MadsLudvig/industrial-core-xy/README.md

# industrial-core-xy
Large scale 3D printer made with old servomotor parts from CNC cantilever robots
