MadsLudvig/industrial-core-xy/DuetXLenze Adapter Board/DuetXLenze-kicad/README.md

# DuetXLenze

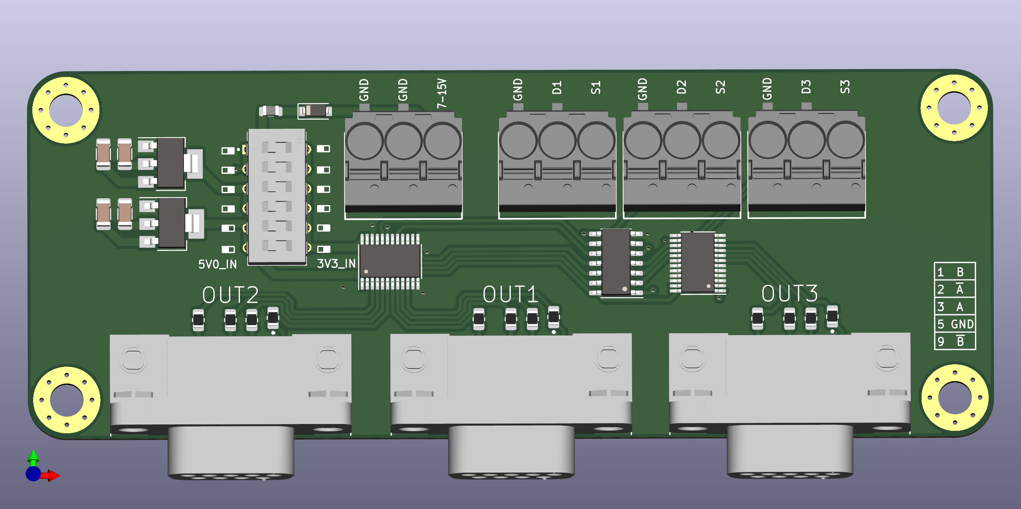
[picture p3: DuetXLenze Adapter Board/DuetXLenze-kicad/Images/DuetXLenze.png]
Preview


### Parts used

__C1 - C4__		JLCPCB Part # C13585

__D1 - D2__		JLCPCB Part # C8598

__FB1 - FB2__	JLCPCB Part # C1015

__J1 - J3__			Farnell Part # 1338747

__R1 - R12__		JLCPCB Part # C28636

__U1__				JLCPCB Part # C6187

__U2__				JLCPCB Part # C6186

__U3 + U5__		JLCPCB Part # C7859

__U4__				JLCPCB Part # C5590

__X1 - X4__		Farnell Part # 2352396

__S1__				Farnel Part # 1123939
