MadsLudvig/industrial-core-xy/DuetXLenze Adapter Board/DuetXLenze-kicad/DuetXLenze.kicad_pcb

## KiCad design DuetXLenze Adapter Board/DuetXLenze-kicad/DuetXLenze.kicad_pcb (2022-08-12)

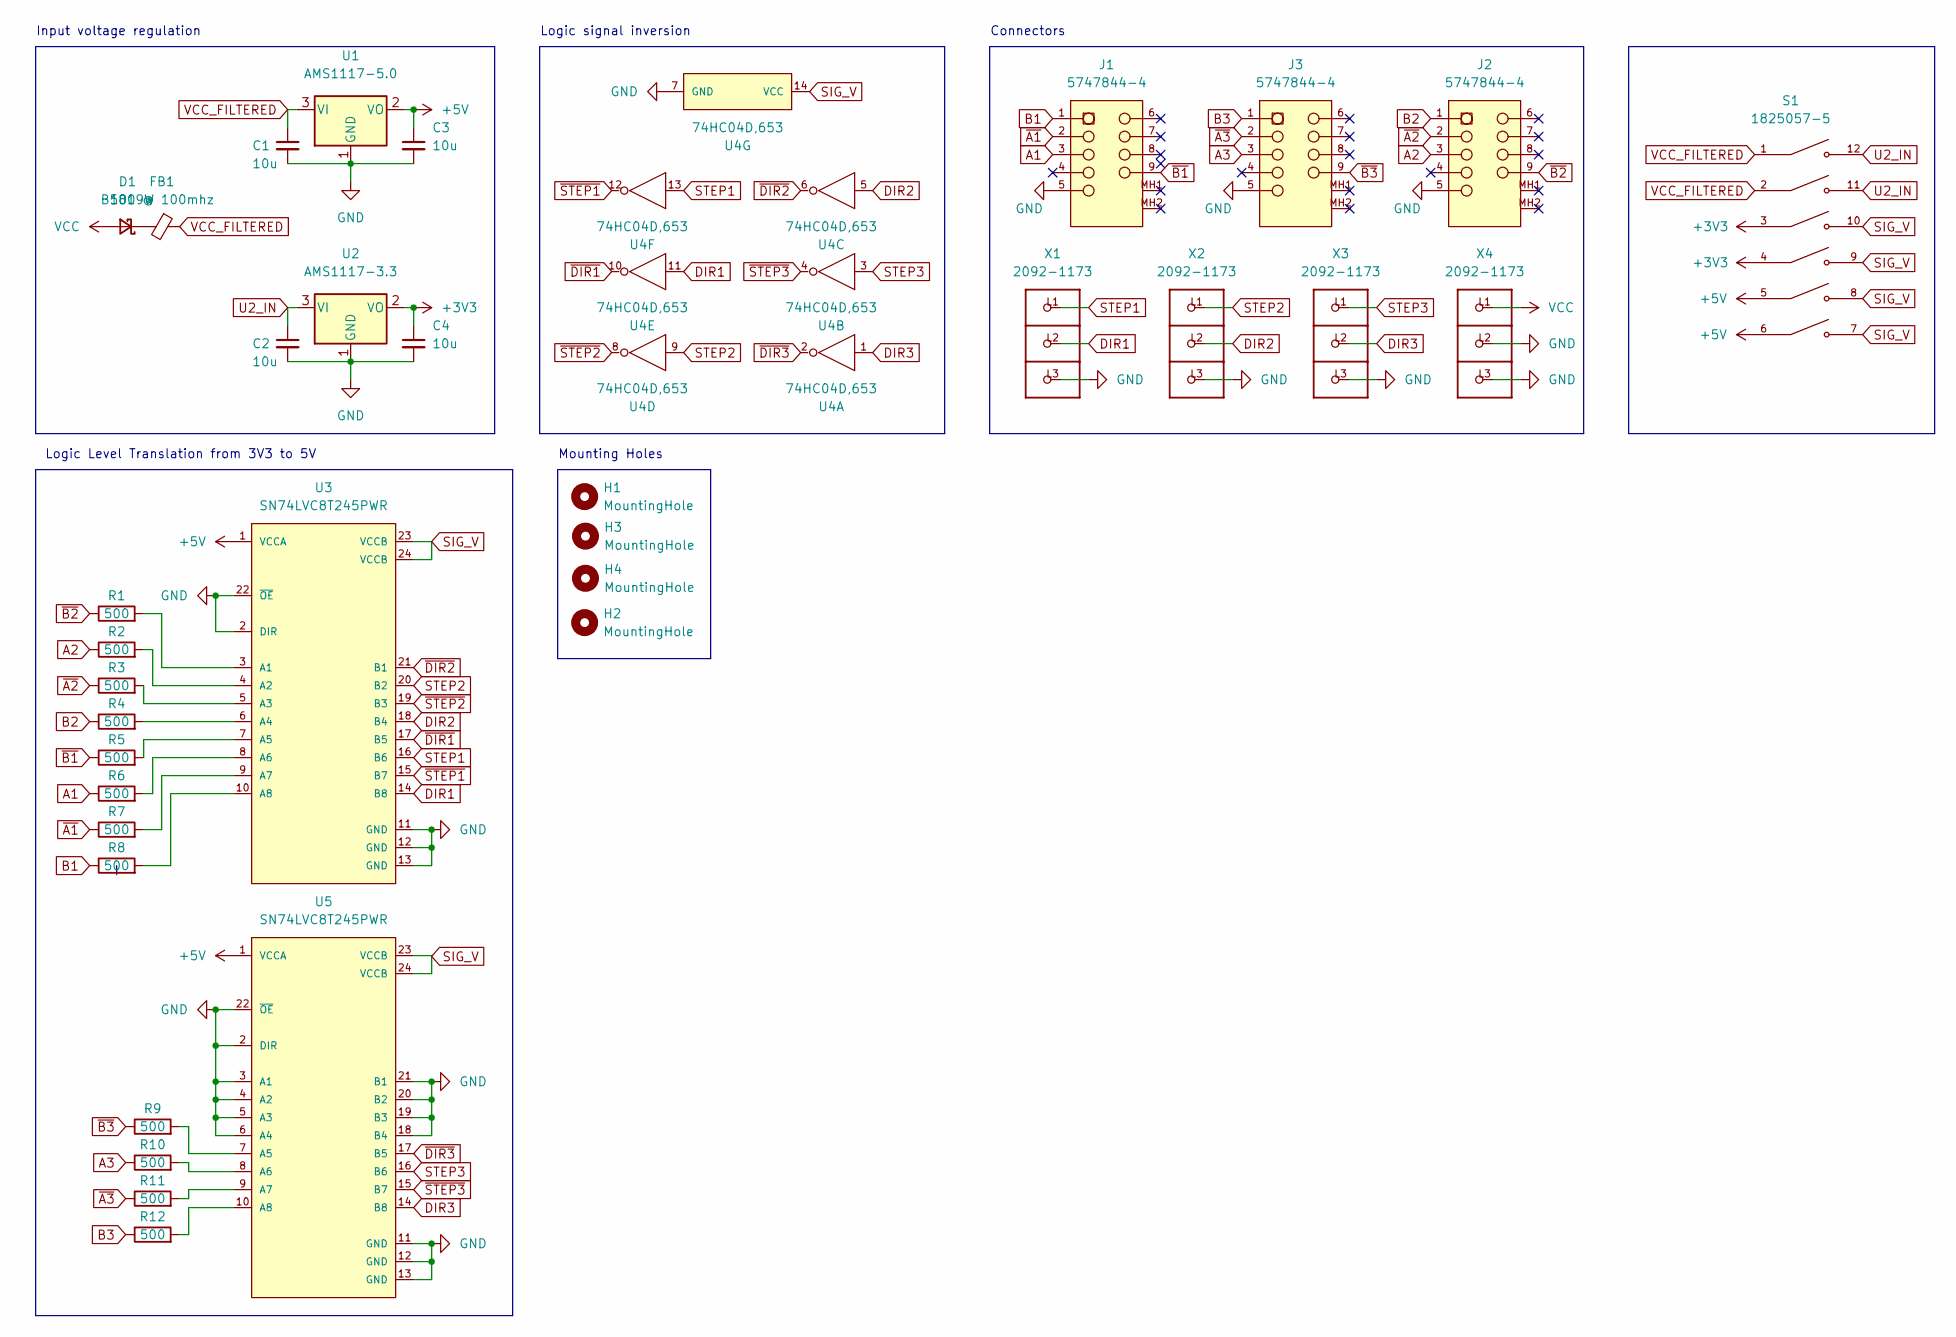
[picture p4: schematic DuetXLenze.kicad_sch]

Parts:
C1, C2, C3, C4: 10u; C_1206_3216Metric
D1: B5819W; D_SOD-123
FB1: 100 @ 100mhz; L_0805_2012Metric
H1, H2, H3, H4: MountingHole; MountingHole_4.3mm_M4_Pad_Via
J1, J2, J3: 5747844-4; TE_Connectivity-5747844-4-0
R1, R2, R3, R4, R5, R6, R7, R8, R9, R10, R11, R12: 500; R_0805_2012Metric
S1: 1825057-5; DIP762W56P254L1772H585Q12
U1: AMS1117-5.0; SOT-223-3_TabPin2
U2: AMS1117-3.3; SOT-223-3_TabPin2
U3, U5: SN74LVC8T245PWR; TSSOP-24_4.4x7.8mm_P0.65mm; mouser part number 595-SN74LVC8T245PWR; digikey description IC TRNSLTR BIDIRECTIONAL 24TSSOP
U4: 74HC04D,653; SOIC-14_3.9x8.7mm_P1.27mm; mouser part number 771-74HC04D-T; digikey description IC INVERTER 6CH 6-INP 14SO
X1, X2, X3, X4: 2092-1173; P-2092-1173

Connections:
+3V3: C4.1, S1.3, S1.4, U2.2 (VO)
+5V: C3.1, S1.5, S1.6, U1.2 (VO), U3.1 (VCCA), U5.1 (VCCA)
A1: J1.3, R6.1
A2: J2.3, R2.1
A3: J3.3, R10.1
B1: J1.1, R8.1
B2: J2.1, R4.1
B3: J3.1, R12.1
DIR1: U3.14 (B8), U4.11 (5A), X1.L2
DIR2: U3.18 (B4), U4.5 (3A), X2.L2
DIR3: U4.1 (1A), U5.14 (B8), X3.L2
GND: C1.2, C2.2, C3.2, C4.2, J1.5, J2.5, J3.5, U1.1 (GND), U2.1 (GND), U3.2 (DIR), U3.11 (GND), U3.12 (GND), U3.13 (GND), U3.22 (~OE), U4.7 (GND), U5.2 (DIR), U5.3 (A1), U5.4 (A2), U5.5 (A3), U5.6 (A4), U5.11 (GND), U5.12 (GND), U5.13 (GND), U5.18 (B4), U5.19 (B3), U5.20 (B2), U5.21 (B1), U5.22 (~OE), X1.L3, X2.L3, X3.L3, X4.L2, X4.L3
unnamed: D1.1 (K), FB1.2
unnamed: R1.2, U3.3 (A1)
unnamed: R2.2, U3.4 (A2)
unnamed: R3.2, U3.5 (A3)
unnamed: R4.2, U3.6 (A4)
unnamed: R5.2, U3.7 (A5)
unnamed: R6.2, U3.8 (A6)
unnamed: R7.2, U3.9 (A7)
unnamed: R8.2, U3.10 (A8)
unnamed: R9.2, U5.7 (A5)
unnamed: R10.2, U5.8 (A6)
unnamed: R11.2, U5.9 (A7)
unnamed: R12.2, U5.10 (A8)
SIG_V: S1.7, S1.8, S1.9, S1.10, U3.23 (VCCB), U3.24 (VCCB), U4.14 (VCC), U5.23 (VCCB), U5.24 (VCCB)
STEP1: U3.16 (B6), U4.13 (6A), X1.L1
STEP2: U3.20 (B2), U4.9 (4A), X2.L1
STEP3: U4.3 (2A), U5.16 (B6), X3.L1
U2_IN: C2.1, S1.11, S1.12, U2.3 (VI)
VCC: D1.2 (A), X4.L1
VCC_FILTERED: C1.1, FB1.1, S1.1, S1.2, U1.3 (VI)
~A1: J1.2, R7.1
~A2: J2.2, R3.1
~A3: J3.2, R11.1
~B1: J1.9, R5.1
~B2: J2.9, R1.1
~B3: J3.9, R9.1
~DIR1: U3.17 (B5), U4.10 (5Y)
~DIR2: U3.21 (B1), U4.6 (3Y)
~DIR3: U4.2 (1Y), U5.17 (B5)
~STEP1: U3.15 (B7), U4.12 (6Y)
~STEP2: U3.19 (B3), U4.8 (4Y)
~STEP3: U4.4 (2Y), U5.15 (B7)

Notes on the sheet:
Input voltage regulation
Mounting Holes
Logic Level Translation from 3V3 to 5V
Logic signal inversion
Connectors

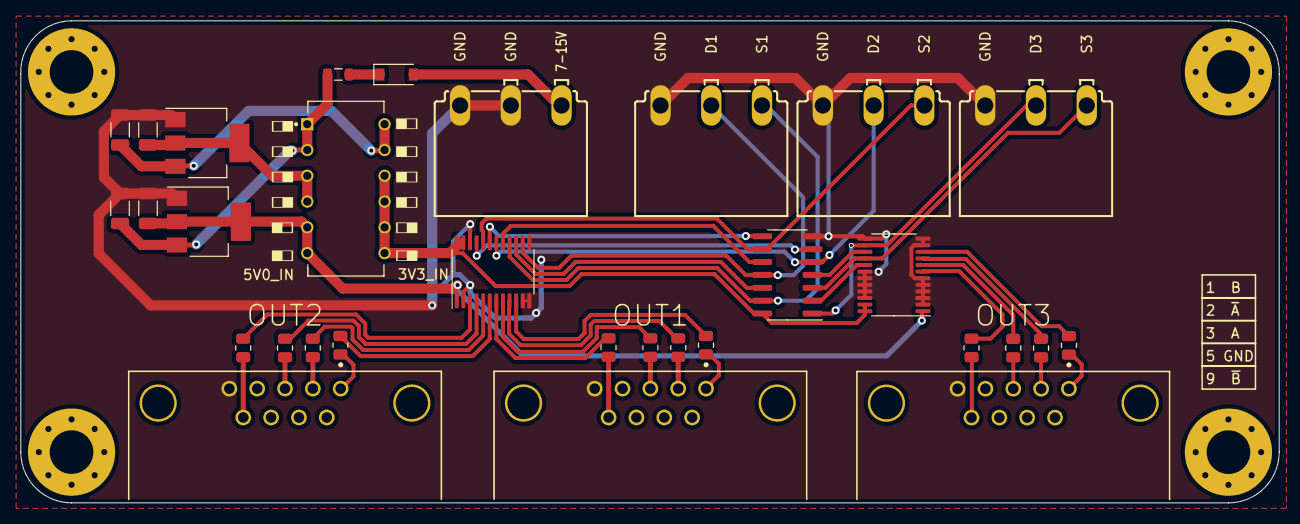
[picture p5: board DuetXLenze.kicad_pcb from above]

Board: 2 copper layers, 124.0 x 47.5 mm, 35 parts (0 on the bottom side), 44 nets.
